xiang056/Smart-Car/Core/Src/main.c

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
/* Includes ------------------------------------------------------------------*/
#include "main.h"

/* USER CODE BEGIN Includes */
#include <stdint.h>
#include <stdio.h>
#include <string.h>
#include "motor_driver.h"
#include "bluetooth.h"
/* USER CODE END Includes */

/* USER CODE BEGIN PTD */
typedef enum {
    CAR_STOP,
    CAR_FORWARD,
    CAR_BACKWARD,
    CAR_LEFT,
    CAR_RIGHT,
    CAR_FORWARD_LEFT,
    CAR_FORWARD_RIGHT,
    CAR_BACKWARD_LEFT,
    CAR_BACKWARD_RIGHT,
} CarState_t;
/* USER CODE END PTD */

/* USER CODE BEGIN PD */
#define IS_FWD(s) ((s)==CAR_FORWARD||(s)==CAR_FORWARD_LEFT||(s)==CAR_FORWARD_RIGHT)
#define IS_BWD(s) ((s)==CAR_BACKWARD||(s)==CAR_BACKWARD_LEFT||(s)==CAR_BACKWARD_RIGHT)
/* USER CODE END PD */

I2C_HandleTypeDef hi2c1;

TIM_HandleTypeDef htim1;
TIM_HandleTypeDef htim2;
TIM_HandleTypeDef htim3;

UART_HandleTypeDef huart6;

void SystemClock_Config(void);
static void MX_GPIO_Init(void);
static void MX_I2C1_Init(void);
static void MX_TIM1_Init(void);
static void MX_TIM2_Init(void);
static void MX_TIM3_Init(void);
static void MX_USART6_UART_Init(void);
/**
  * @brief  The application entry point.
  * @retval int
  */
int main(void)
{

  /* MCU Configuration--------------------------------------------------------*/

  /* Reset of all peripherals, Initializes the Flash interface and the Systick. */
  HAL_Init();

  /* Configure the system clock */
  SystemClock_Config();

  /* Initialize all configured peripherals */
  MX_GPIO_Init();
  MX_I2C1_Init();
  MX_TIM1_Init();
  MX_TIM2_Init();
  MX_TIM3_Init();
  MX_USART6_UART_Init();
  /* USER CODE BEGIN 2 */
  HAL_Delay(2000);
  motor_init(&htim1);
  bluetooth_init(&huart6);

  char boot_msg[] = "SmartCar Ready\r\n";
  HAL_UART_Transmit(&huart6, (uint8_t*)boot_msg, strlen(boot_msg), 100);
  /* USER CODE END 2 */

  /* Infinite loop */
  /* USER CODE BEGIN WHILE */
  while (1)
  {
    /* USER CODE END WHILE */

    /* USER CODE BEGIN 3 */
    static CarState_t state        = CAR_STOP;
    static CarState_t pending      = CAR_STOP;  /* 換向緩衝：等停止後再套用 */
    static uint32_t   stop_until   = 0;         /* 停止保持到這個 tick */
    static uint32_t   last_print   = 0;

    /* 換向緩衝：停止 100ms 後才切換到 pending 狀態 */
    if (pending != CAR_STOP && HAL_GetTick() >= stop_until) {
        state   = pending;
        pending = CAR_STOP;
    }

    /* 藍牙指令 */
    BtCmd_t bt = bluetooth_get_cmd();
    if (bt != BT_CMD_NONE) {
        switch (bt) {
            case BT_CMD_FORWARD:
                if (IS_BWD(state)) {          /* 後退→前進：插入 100ms 停止 */
                    state      = CAR_STOP;
                    pending    = CAR_FORWARD;
                    stop_until = HAL_GetTick() + 100;
                } else {
                    state = CAR_FORWARD;
                }
                break;
            case BT_CMD_BACKWARD:
                if (IS_FWD(state)) {          /* 前進→後退：插入 100ms 停止 */
                    state      = CAR_STOP;
                    pending    = CAR_BACKWARD;
                    stop_until = HAL_GetTick() + 100;
                } else {
                    state = CAR_BACKWARD;
                }
                break;
            case BT_CMD_LEFT:
                if (state == CAR_FORWARD  || state == CAR_FORWARD_LEFT  || state == CAR_FORWARD_RIGHT)
                    state = CAR_FORWARD_LEFT;
                else if (state == CAR_BACKWARD || state == CAR_BACKWARD_LEFT || state == CAR_BACKWARD_RIGHT)
                    state = CAR_BACKWARD_LEFT;
                else if (state == CAR_RIGHT)
                    state = CAR_STOP;  /* 反向 pivot 先停，避免方向瞬切 */
                else
                    state = CAR_LEFT;
                break;
            case BT_CMD_RIGHT:
                if (state == CAR_FORWARD  || state == CAR_FORWARD_LEFT  || state == CAR_FORWARD_RIGHT)
                    state = CAR_FORWARD_RIGHT;
                else if (state == CAR_BACKWARD || state == CAR_BACKWARD_LEFT || state == CAR_BACKWARD_RIGHT)
                    state = CAR_BACKWARD_RIGHT;
                else if (state == CAR_LEFT)
                    state = CAR_STOP;  /* 反向 pivot 先停，避免方向瞬切 */
                else
                    state = CAR_RIGHT;
                break;
            case BT_CMD_STOP:
                state = CAR_STOP;
                break;
            default: break;
        }
    }

    /* 狀態機 */
    switch (state) {
        case CAR_STOP:
            motor_stop();
            break;
        case CAR_FORWARD:
            motor_drive(MOTOR_FORWARD, MOTOR_PWM_MAX, MOTOR_FORWARD, MOTOR_PWM_MAX);
            break;
        case CAR_BACKWARD:
            motor_drive(MOTOR_BACKWARD, MOTOR_PWM_MAX, MOTOR_BACKWARD, MOTOR_PWM_MAX);
            break;
        case CAR_LEFT:
            motor_drive(MOTOR_STOP, 0, MOTOR_FORWARD, MOTOR_PWM_MAX);
            break;
        case CAR_RIGHT:
            motor_drive(MOTOR_FORWARD, MOTOR_PWM_MAX, MOTOR_STOP, 0);
            break;
        case CAR_FORWARD_LEFT:
            motor_drive(MOTOR_FORWARD, MOTOR_PWM_INNER, MOTOR_FORWARD, MOTOR_PWM_MAX);
            break;
        case CAR_FORWARD_RIGHT:
            motor_drive(MOTOR_FORWARD, MOTOR_PWM_MAX, MOTOR_FORWARD, MOTOR_PWM_INNER);
            break;
        case CAR_BACKWARD_LEFT:
            motor_drive(MOTOR_BACKWARD, MOTOR_PWM_INNER, MOTOR_BACKWARD, MOTOR_PWM_MAX);
            break;
        case CAR_BACKWARD_RIGHT:
            motor_drive(MOTOR_BACKWARD, MOTOR_PWM_MAX, MOTOR_BACKWARD, MOTOR_PWM_INNER);
            break;
    }

    /* telemetry：每 300ms 送一次給 App */
    if (HAL_GetTick() - last_print >= 300) {
        last_print = HAL_GetTick();  /* 先記錄時間，避免阻塞傳輸導致計時偏移 */
        uint16_t spd_pct = (state == CAR_STOP) ? 0
                         : (state == CAR_FORWARD_LEFT || state == CAR_BACKWARD_LEFT
                            || state == CAR_FORWARD_RIGHT || state == CAR_BACKWARD_RIGHT)
                           ? (MOTOR_PWM_INNER * 100U / MOTOR_PWM_MAX) : 100;
        bluetooth_send_status(spd_pct, state);
    }

    HAL_Delay(20);
  }
  /* USER CODE END 3 */
}

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
