xiang056/Smart-Car/Smart_Car_v1.ioc

Mcu.UserName=STM32F407VGTx
PA13.GPIO_Label=SWDIO
PA13.Signal=SYS_JTMS-SWDIO
PA14.GPIO_Label=SWCLK
PA14.Signal=SYS_JTCK-SWCLK
PA2.Signal=S_TIM2_CH3
PB4.Signal=S_TIM3_CH1
PB6.Signal=I2C1_SCL
PB7.Signal=I2C1_SDA
PC13-ANTI_TAMP.Signal=GPIO_Input
PC6.Signal=USART6_TX
PC7.Signal=USART6_RX
PD13.Signal=GPIO_Output
PE11.Signal=GPIO_Output
PE13.Signal=GPIO_Output
PE14.Signal=S_TIM1_CH4
PE5.Signal=GPIO_Output
PE6.Signal=GPIO_Output
PE9.Signal=S_TIM1_CH1
PH0-OSC_IN.GPIO_Label=PH0-OSC_IN
PH0-OSC_IN.Signal=RCC_OSC_IN
PH1-OSC_OUT.GPIO_Label=PH1-OSC_OUT
PH1-OSC_OUT.Signal=RCC_OSC_OUT
