xiang056/Smart-Car/Core/Inc/motor_driver.h

#ifndef __MOTOR_DRIVER_H
#define __MOTOR_DRIVER_H

#include "stm32f4xx_hal.h"

#define MOTOR_PWM_MAX    33599  /* TIM1 ARR，168MHz / 33600 = 5kHz PWM */
#define MOTOR_PWM_INNER  (MOTOR_PWM_MAX * 6 / 10)   /* 曲線轉向內輪速 60% */

typedef enum {
    MOTOR_FORWARD,
    MOTOR_BACKWARD,
    MOTOR_STOP
} MotorDir_t;

void motor_init(TIM_HandleTypeDef *htim);

/*
 * 左右輪獨立控制
 *   left_dir / right_dir : MOTOR_FORWARD, MOTOR_BACKWARD, MOTOR_STOP
 *   left_spd / right_spd : 0 ~ MOTOR_PWM_MAX
 */
void motor_drive(MotorDir_t left_dir,  uint16_t left_spd,
                 MotorDir_t right_dir, uint16_t right_spd);

void motor_stop(void);

#endif /* __MOTOR_DRIVER_H */
