xiang056/Smart-Car/(commit log)

2026-05-13 Initial commit: Smart Car V1 STM32 project
2026-05-22 feat: differential drive state machine + BLE-ready refactor
    - Refactor main loop into CarState_t state machine (STOP/FORWARD/BACKWARD/LEFT/RIGHT/AV_BRAKE/AV_BACKUP/AV_TURN/AV_CHECK)
    - Replace motor_set() with motor_drive(left_dir, left_spd, right_dir, right_spd) for independent left/right wheel control
    - Avoidance sequence: brake 150ms → backup 500ms → pivot turn 700ms → path check
    - Bidirectional obstacle counters (obs_cnt/clr_cnt) prevent single spurious reading from resetting detection
    - Remove servo steering dependency (differential drive replaces servo turning)
    [main.c, motor_driver.c, motor_driver.h]
2026-06-02 fix: BLE rx pipeline, motor direction, pivot turn, avoidance temp disable
    - Fix motor FORWARD/BACKWARD GPIO polarity (was physically reversed)
    - Change L/R to pivot turn (outer wheel full, inner wheel stop)
    - Add avoidance_off flag to disable obstacle avoidance during hw debug
    - Remove duplicate HAL_UART callbacks from main.c (already in it.c)
    - Remove startup motor test and echo debug code
    - Add DEVLOG.md with today's changes and feature status
    [bluetooth.c, main.c, motor_driver.c, motor_driver.h]
2026-06-03 fix: telemetry BLE MTU, ultrasonic DWT timing, avoidance threshold
    - Telemetry format shortened to S,spd,ang,dist,obs\n (max 15B < 20B MTU)
    - Ultrasonic: replace TIM2 counter with DWT cycle counter for reliable µs timing
    - Ultrasonic: use HAL_Delay(1) for TRIG pulse, add 2ms LOW pre-delay
    - Ultrasonic: ECHO moved from PA2 to PC2 (avoid TIM2_CH3/USART2 conflict)
    - Avoidance: obstacle threshold widened from 20cm to 40cm
    - IR sensor: temporarily disabled to prevent floating-pin false triggers
    - Remove avoidance_off debug flag, restore normal avoidance logic
    [bluetooth.c, main.c]
2026-06-03 refactor: remove servo dependency from main.c
    Servo not needed with differential drive steering.
    Remove servo_init() call and servo_driver.h include.
2026-06-04 refactor: hardware trim, differential steering, protocol simplification
    Hardware changes:
    - Remove HC-SR04, IR sensor, SG90 servo (space constraint)
    - HC-05 -> HM-10 BLE (3.3V compatible, no voltage divider needed)
    Firmware (STM32):
    - Delete ultrasonic_driver, ir_sensor_driver, servo_driver modules
    - Replace 9-state avoidance FSM with 9-state drive FSM:
    STOP/FORWARD/BACKWARD/LEFT/RIGHT + 4 compound curve states
    - Differential steering: L/R while moving = inner wheel 40%, outer 100%
    L/R while stopped = pivot turn (one wheel stop)
    - Move PWM_INNER constant to motor_driver.h as MOTOR_PWM_INNER
    - Simplify telemetry: S,speed,angle,dist,obs -> S,speed,state (2 fields)
    - Remove ultrasonic_capt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
    [bluetooth.c, bluetooth.h, main.c, motor_driver.h]
2026-06-05 fix: code review corrections — pivot safety, snprintf guard, telemetry timing
    - bluetooth.h: extend state comment to all 9 CarState_t values (0-8)
    - bluetooth.c: guard snprintf return value before casting to uint16_t
    - main.c: opposite pivot (LEFT<->RIGHT) now stops first to prevent
    full-PWM direction reversal; stamp last_print before blocking transmit
    to keep 300ms telemetry interval stable
    - SmartCar_ProjectPlan.md: remove deleted servo_driver.h/c from file
    tree and module table
    [bluetooth.c, bluetooth.h, main.c]
2026-06-10 feat: direction-change protection, 5kHz PWM, 60% inner wheel
    - Insert 100ms stop when switching FORWARD↔BACKWARD to prevent motor stall
    - Lower PWM from 20kHz to 5kHz (ARR 8399→33599) for better L298N efficiency
    - Raise inner wheel speed from 40% to 60% for more reliable differential turn
    - Update README with full hardware spec, wiring, state machine table, photos placeholder
    [main.c, motor_driver.h]
2026-06-11 refactor: move IS_FWD/IS_BWD to file scope, fix telemetry speed
    - Move IS_FWD / IS_BWD macros from inside while(1) to file-scope PD section
    - Fix telemetry speed_pct: report 60% for turning states, 100% for straight
    - Remove stale 10kHz comment in motor_driver.h; clarify 5kHz calculation
    [main.c, motor_driver.h]
